DiplomInformatikerFranzHoepfinger/mpcie-breakout/photos/mpcie-breakout-back.jpg

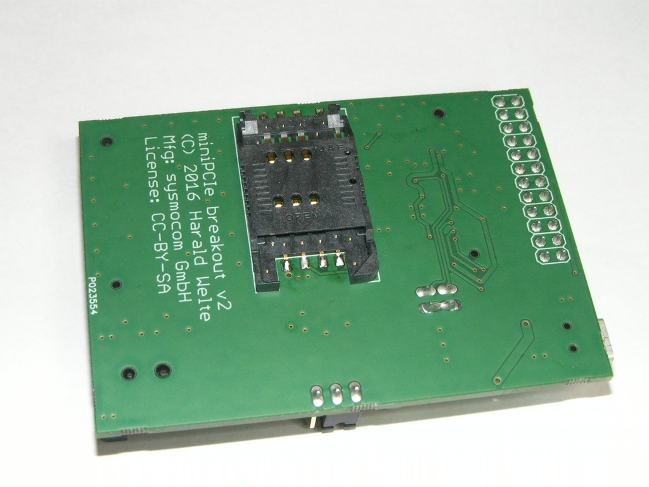
photos/mpcie-breakout-back.jpg
