DiplomInformatikerFranzHoepfinger/mpcie-breakout/photos/mpcie-breakout-v3-perspective.jpg

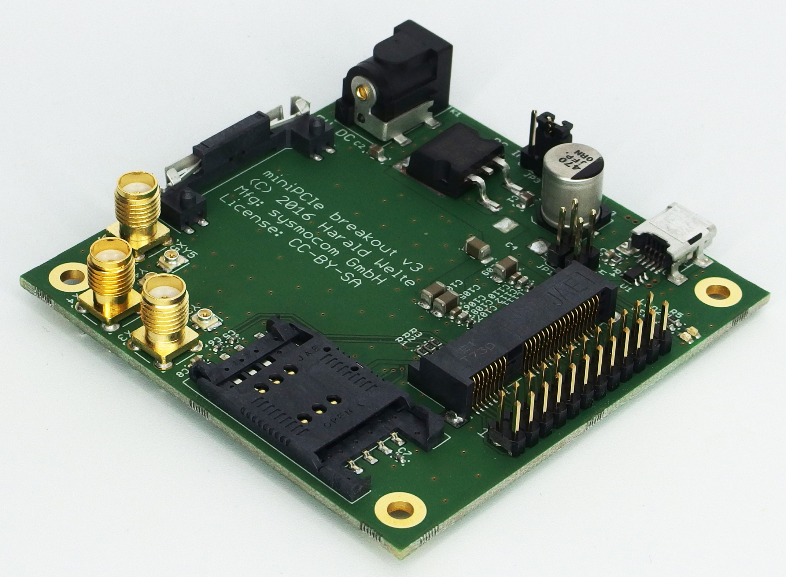
photos/mpcie-breakout-v3-perspective.jpg
