DiplomInformatikerFranzHoepfinger/mpcie-breakout/README.md

# mpcie-breakout
https://osmocom.org/projects/mpcie-breakout/wiki --> advance this.
