DiplomInformatikerFranzHoepfinger/mpcie-breakout/photos/mpcie-breakout-front.jpg

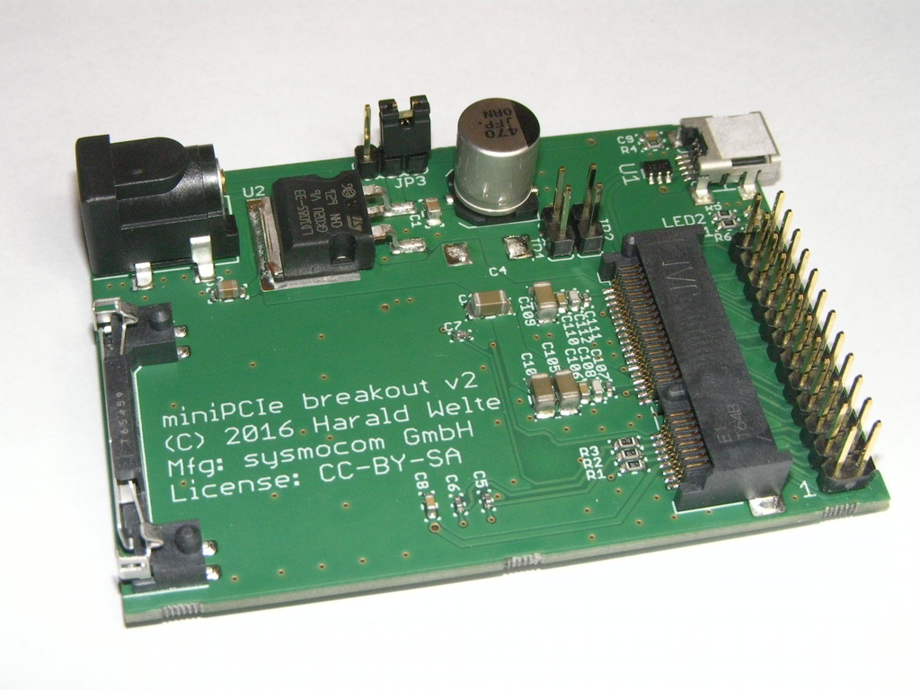
photos/mpcie-breakout-front.jpg
