DiplomInformatikerFranzHoepfinger/mpcie-breakout/photos/mpcie-breakout-v3-top.jpg

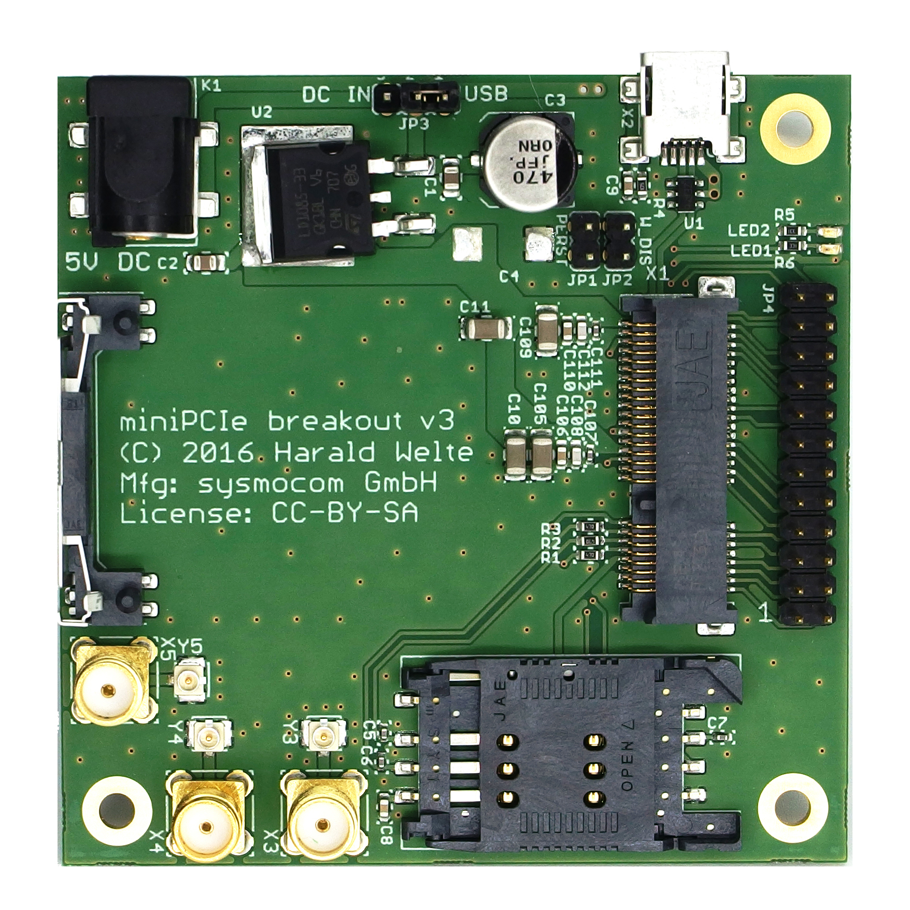
photos/mpcie-breakout-v3-top.jpg
