DiplomInformatikerFranzHoepfinger/mpcie-breakout/mpcie-breakout.pdf

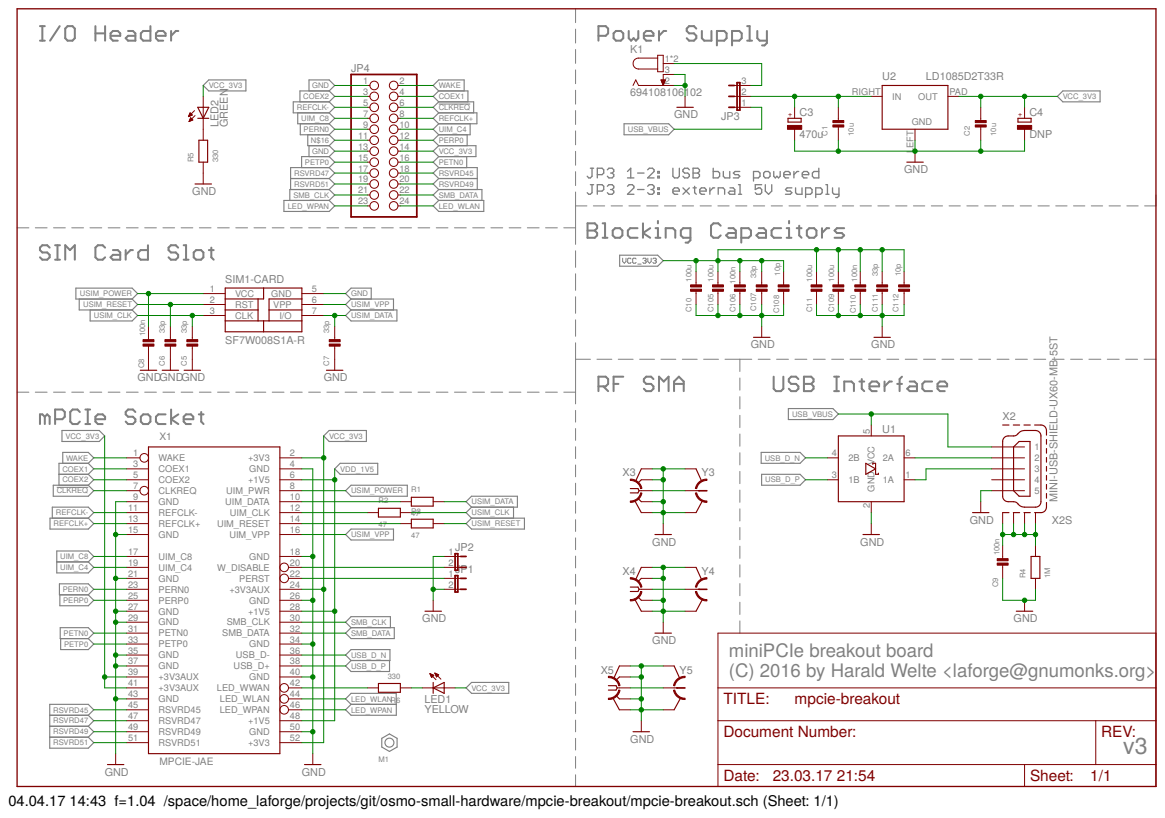
[picture p5: page 1]

MINI-USB-SHIELD-UX60-MB-5S

10 UIM_PWR 12 UIM_DATA
14 UIM_CLK
16 UIM_RESET

18 20 GND

30 +3V3AUX 26 28 GND

GND
miniPCIe breakout board
(C) 2016 by Harald Welte <laforge@gnumonks.org>
TITLE:
Document Number:

04.04.17 14:43 f=1.04 /space/home_laforge/projects/git/osmo-small-hardware/mpcie-breakout/mpcie-breakout.sch (Sheet: 1/1)
