DiplomInformatikerFranzHoepfinger/mpcie-breakout/mpcie-breakout_brd.pdf

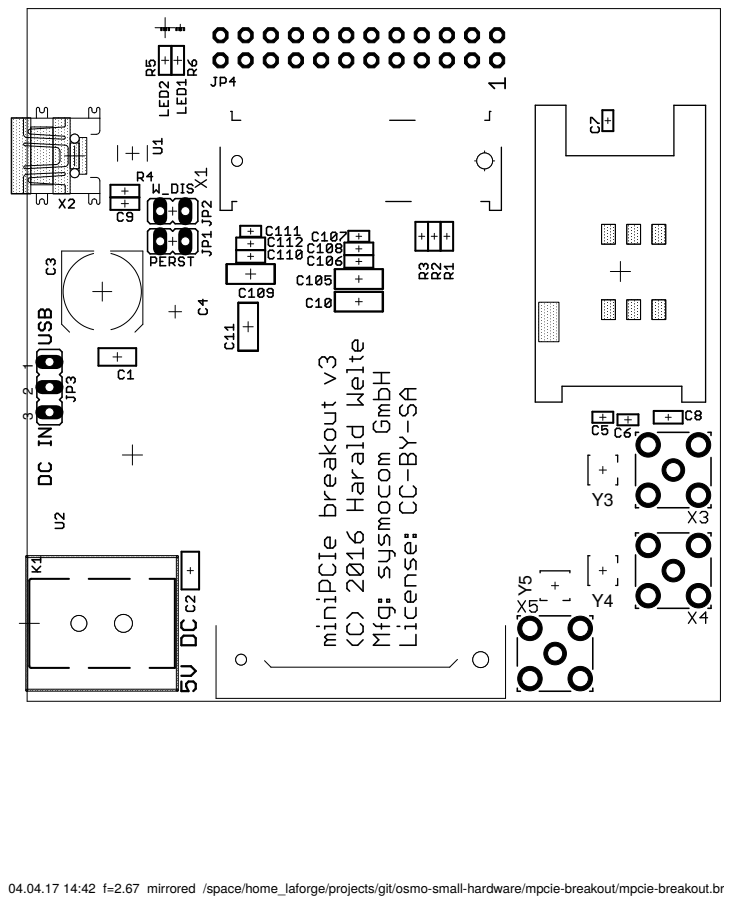
[picture p6: page 1]

04.04.17 14:42 f=2.67 mirrored /space/home_laforge/projects/git/osmo-small-hardware/mpcie-breakout/mpcie-breakout.brd
