DiplomInformatikerFranzHoepfinger/mpcie-breakout/mpcie-breakout.brd

## EAGLE design mpcie-breakout.brd (2021-05-27)

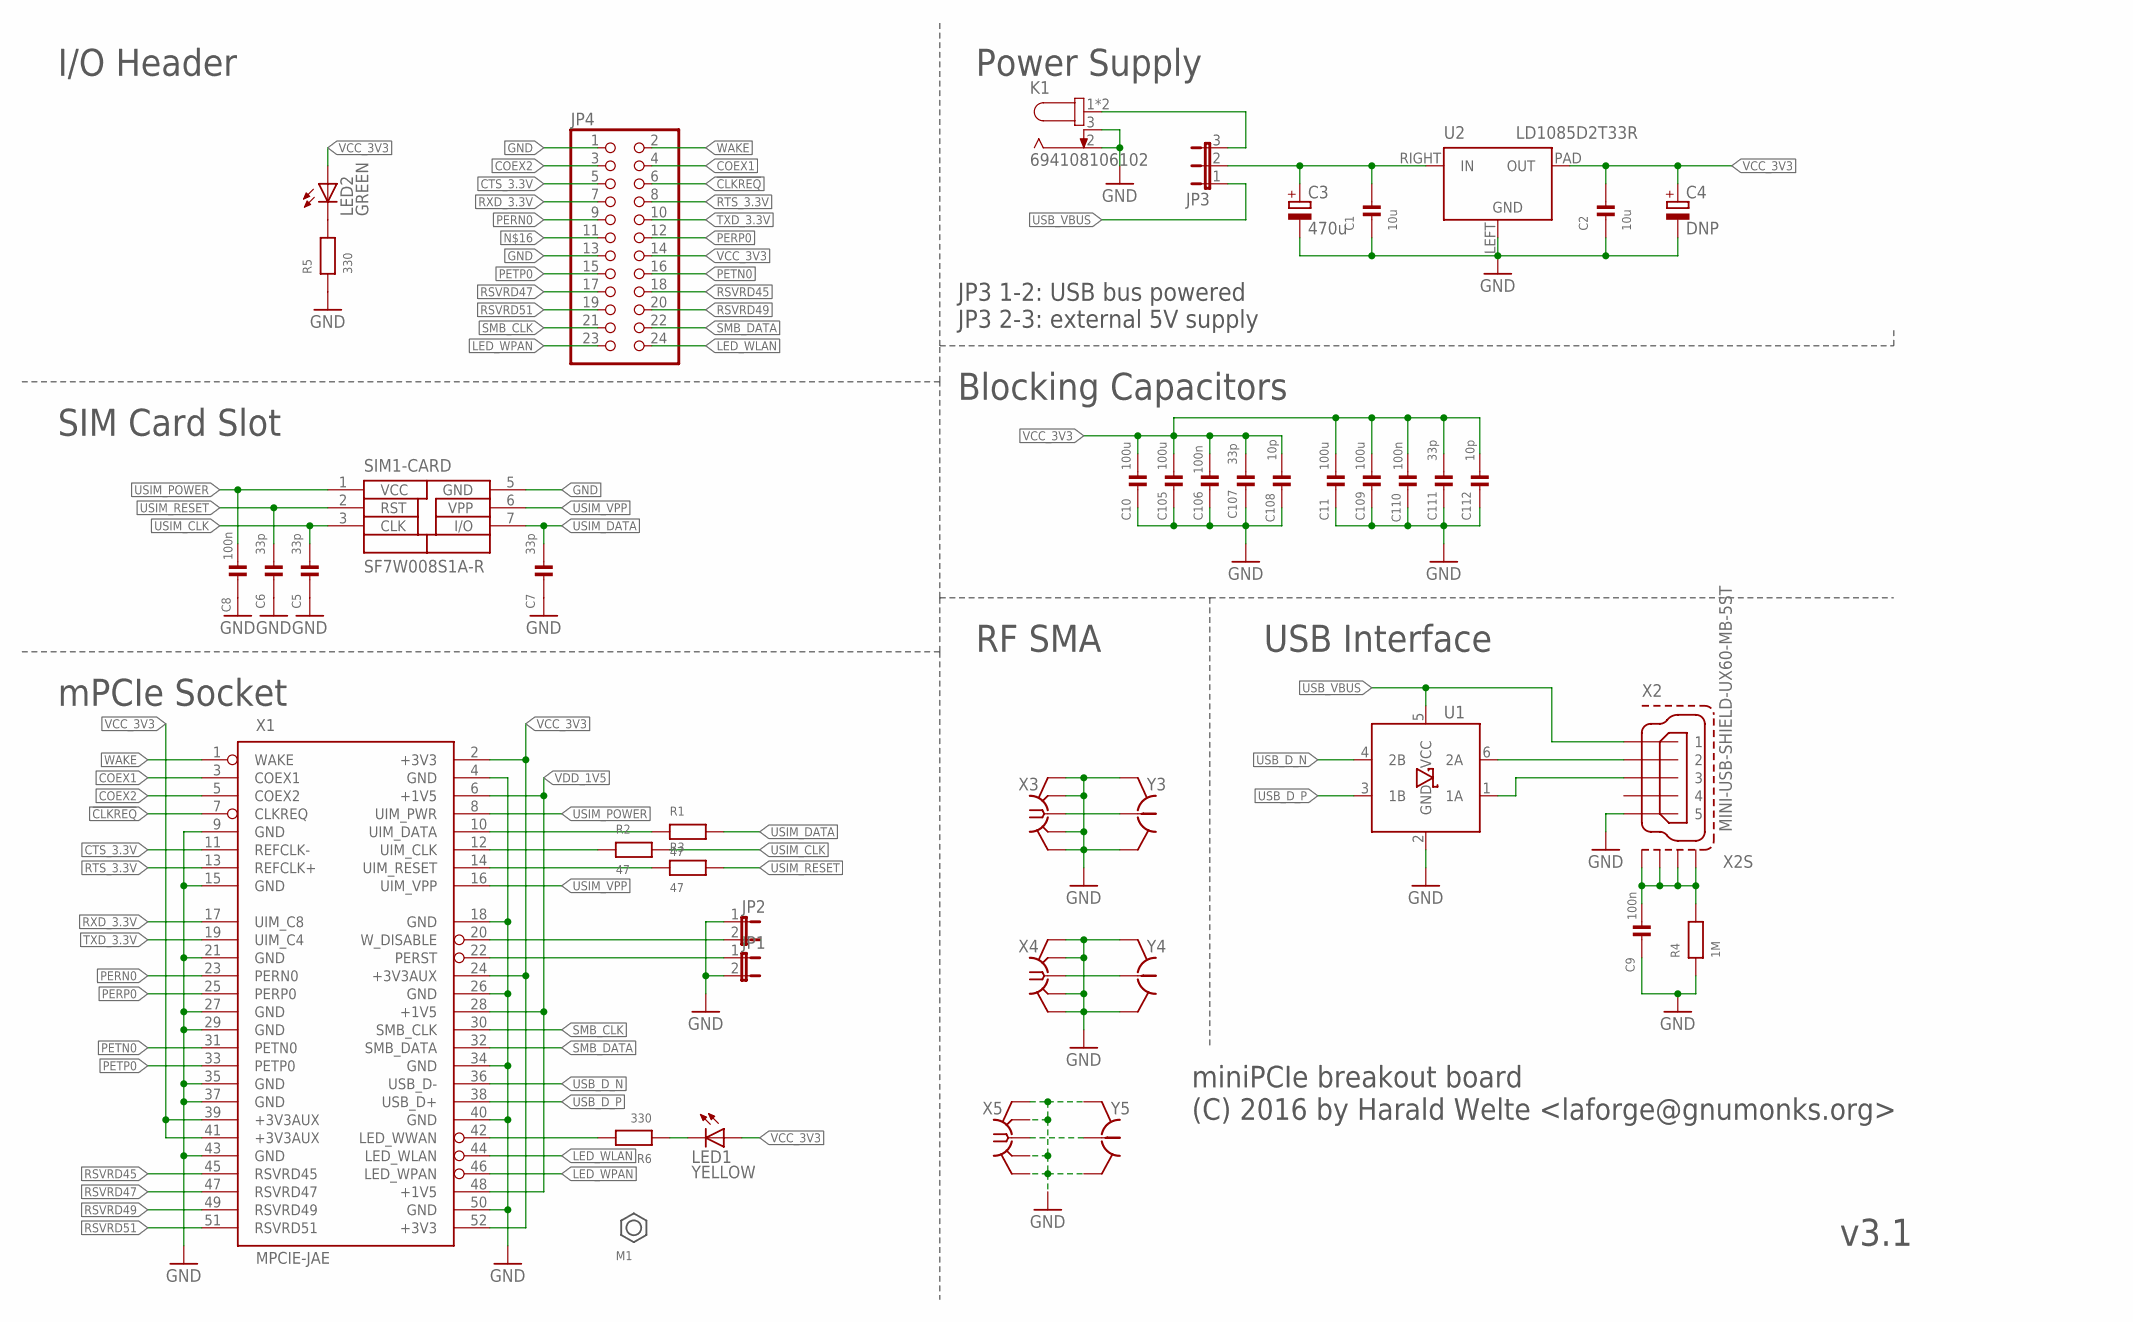
[picture p7: schematic mpcie-breakout.sch]

Parts:
C1, C2: 10u; _0805; MANUFACTURERPARTNUMBER CL21A106KOQNNNG
C3: 470u; UD-8X10_NICHICON; MANUFACTURERPARTNUMBER UUR0J471MNL1GS
C4: DNP; SMC_E; MANUFACTURERPARTNUMBER UNKNOWN MANUFACTURER PART NUMBER
C5, C6, C7, C107, C111: 33p; _0402; MANUFACTURERPARTNUMBER CL05C330JB5NNNC
C8, C9, C106, C110: 100n; _0603; MANUFACTURERPARTNUMBER CL10B104KO8NNNC
C10, C11, C105, C109: 100u; 1206; MANUFACTURERPARTNUMBER GRM31CR60J107ME39K
C108, C112: 10p; _0603; MANUFACTURERPARTNUMBER C0603C100J5GACTU
JP1, JP2: JP1E; JP1; MANUFACTURERPARTNUMBER UNKNOWN MANUFACTURER PART NUMBER
JP3: JP2E; JP2; MANUFACTURERPARTNUMBER UNKNOWN MANUFACTURER PART NUMBER
JP4: PINHD-2X12; 2X12; MANUFACTURERPARTNUMBER 961224-6404-AR
K1: 694108106102; MANUFACTURERPARTNUMBER 694108106102
LED1: YELLOW; CHIP-LED0603; MANUFACTURERPARTNUMBER UNKNOWN MANUFACTURER PART NUMBER
LED2: GREEN; CHIP-LED0603; MANUFACTURERPARTNUMBER UNKNOWN MANUFACTURER PART NUMBER
R1, R2, R3: 47; _0603; MANUFACTURERPARTNUMBER RC0603JR-0747RL
R4: 1M; _0603; MANUFACTURERPARTNUMBER RC0603JR-071ML
R5, R6: 330; _0603; MANUFACTURERPARTNUMBER RC0603JR-07330RL
SIM1: SF7W008S1A-R; SF7W008S1A-RESTR; MANUFACTURERPARTNUMBER SF7W008S1AE900
U1: IP4234CZ6; TSOP-6; MANUFACTURERPARTNUMBER IP4234CZ6,125
U2: LD1085D2T33R; ST_D2PAK; MANUFACTURERPARTNUMBER LD1085D2T33R
X1: MPCIE-JAE; MM60-52; MANUFACTURERPARTNUMBER MM60-52B1-E1-R650
X2: MINI-USB-SHIELD-UX60-MB-5ST; UX60-MB-5ST; MANUFACTURERPARTNUMBER UX60-MB-5ST
X3, X4, X5: SMA-F-S-TH; MANUFACTURERPARTNUMBER 5-1814832-1
Y3, Y4, Y5: HRS_UFL; MANUFACTURERPARTNUMBER U.FL-R-SMT(01)

Connections:
!CLKREQ: JP4.6, X1.7 (CLKREQ)
COEX1: JP4.4, X1.3 (COEX1)
COEX2: JP4.3, X1.5 (COEX2)
CTS_3.3V: JP4.5, X1.11 (REFCLK-)
GND: C1.1, C2.1, C3.-, C4.-, C5.2, C6.2, C7.2, C8.1, C9.1, C10.1, C11.1, C105.1, C106.1, C107.2, C108.2, C109.1, C110.1, C111.2, C112.2, JP1.2, JP2.1, JP4.1, JP4.13, K1.2, K1.3, R4.1, R5.1, SIM1.5 (GND), U1.2 (GND), U2.LEFT (GND), X1.4 (GND), X1.9 (GND), X1.15 (GND), X1.18 (GND), X1.21 (GND), X1.26 (GND), X1.27 (GND), X1.29 (GND), X1.34 (GND), X1.35 (GND), X1.37 (GND), X1.40 (GND), X1.43 (GND), X1.50 (GND), X2.5, X3.G1 (GND), X3.G2 (GND), X3.G3 (GND), X3.G4 (GND), X4.G1 (GND), X4.G2 (GND), X4.G3 (GND), X4.G4 (GND), X5.G1 (GND), X5.G2 (GND), X5.G3 (GND), X5.G4 (GND), Y3.GND@1 (GND), Y3.GND@2 (GND), Y4.GND@1 (GND), Y4.GND@2 (GND), Y5.GND@1 (GND), Y5.GND@2 (GND)
LDO_IN: C1.2, C3.+, JP3.2, U2.RIGHT (IN)
LED_WLAN: JP4.24, X1.44 (LED_WLAN)
LED_WPAN: JP4.23, X1.46 (LED_WPAN)
unnamed: LED2.C, R5.2
unnamed: LED1.C, R6.1
unnamed: R6.2, X1.42 (LED_WWAN)
unnamed: R1.1, X1.10 (UIM_DATA)
unnamed: X5.C (1), Y5.SIG (1)
unnamed: R2.1, X1.12 (UIM_CLK)
unnamed: R3.1, X1.14 (UIM_RESET)
unnamed: C9.2, R4.2, X2.M1 (S1), X2.M2 (S2), X2.M3 (S3), X2.M4 (S4)
unnamed: JP3.3, K1.1, K1.1-1 (1)
unnamed: X3.C (1), Y3.SIG (1)
unnamed: X4.C (1), Y4.SIG (1)
PERN0: JP4.9, X1.23 (PERN0)
PERP0: JP4.12, X1.25 (PERP0)
PERST: JP1.1, X1.22 (PERST)
PETN0: JP4.16, X1.31 (PETN0)
PETP0: JP4.15, X1.33 (PETP0)
RSVRD45: JP4.18, X1.45 (RSVRD45)
RSVRD47: JP4.17, X1.47 (RSVRD47)
RSVRD49: JP4.20, X1.49 (RSVRD49)
RSVRD51: JP4.19, X1.51 (RSVRD51)
RTS_3.3V: JP4.8, X1.13 (REFCLK+)
RXD_3.3V: JP4.7, X1.17 (UIM_C8)
SMB_CLK: JP4.21, X1.30 (SMB_CLK)
SMB_DATA: JP4.22, X1.32 (SMB_DATA)
TXD_3.3V: JP4.10, X1.19 (UIM_C4)
USB_D_N: U1.4 (2B), X1.36 (USB_D-)
USB_D_P: U1.3 (1B), X1.38 (USB_D+)
USB_VBUS: JP3.1, U1.5 (VCC), X2.1
USIM_CLK: C5.1, R2.2, SIM1.3 (CLK)
USIM_DATA: C7.1, R1.2, SIM1.7 (I/O)
USIM_POWER: C8.2, SIM1.1 (VCC), X1.8 (UIM_PWR)
USIM_RESET: C6.1, R3.2, SIM1.2 (RST)
USIM_VPP: SIM1.6 (VPP), X1.16 (UIM_VPP)
VCC_3V3: C2.2, C4.+, C10.2, C11.2, C105.2, C106.2, C107.1, C108.1, C109.2, C110.2, C111.1, C112.1, JP4.14, LED1.A, LED2.A, U2.PAD (OUT), X1.2 (+3V3), X1.24 (+3V3AUX), X1.39 (+3V3AUX), X1.41 (+3V3AUX), X1.52 (+3V3)
VDD_1V5: X1.6 (+1V5), X1.28 (+1V5), X1.48 (+1V5)
WAKE: JP4.2, X1.1 (WAKE)
W_DISABLE: JP2.2, X1.20 (W_DISABLE)
_USB_D_N: U1.6 (2A), X2.2
_USB_D_P: U1.1 (1A), X2.3

Notes on the sheet:
miniPCIe breakout board (C) 2016 by Harald Welte <laforge@gnumonks.org>
I/O Header
SIM Card Slot
mPCIe Socket
Power Supply
Blocking Capacitors
USB Interface
JP3 1-2: USB bus powered JP3 2-3: external 5V supply
RF SMA

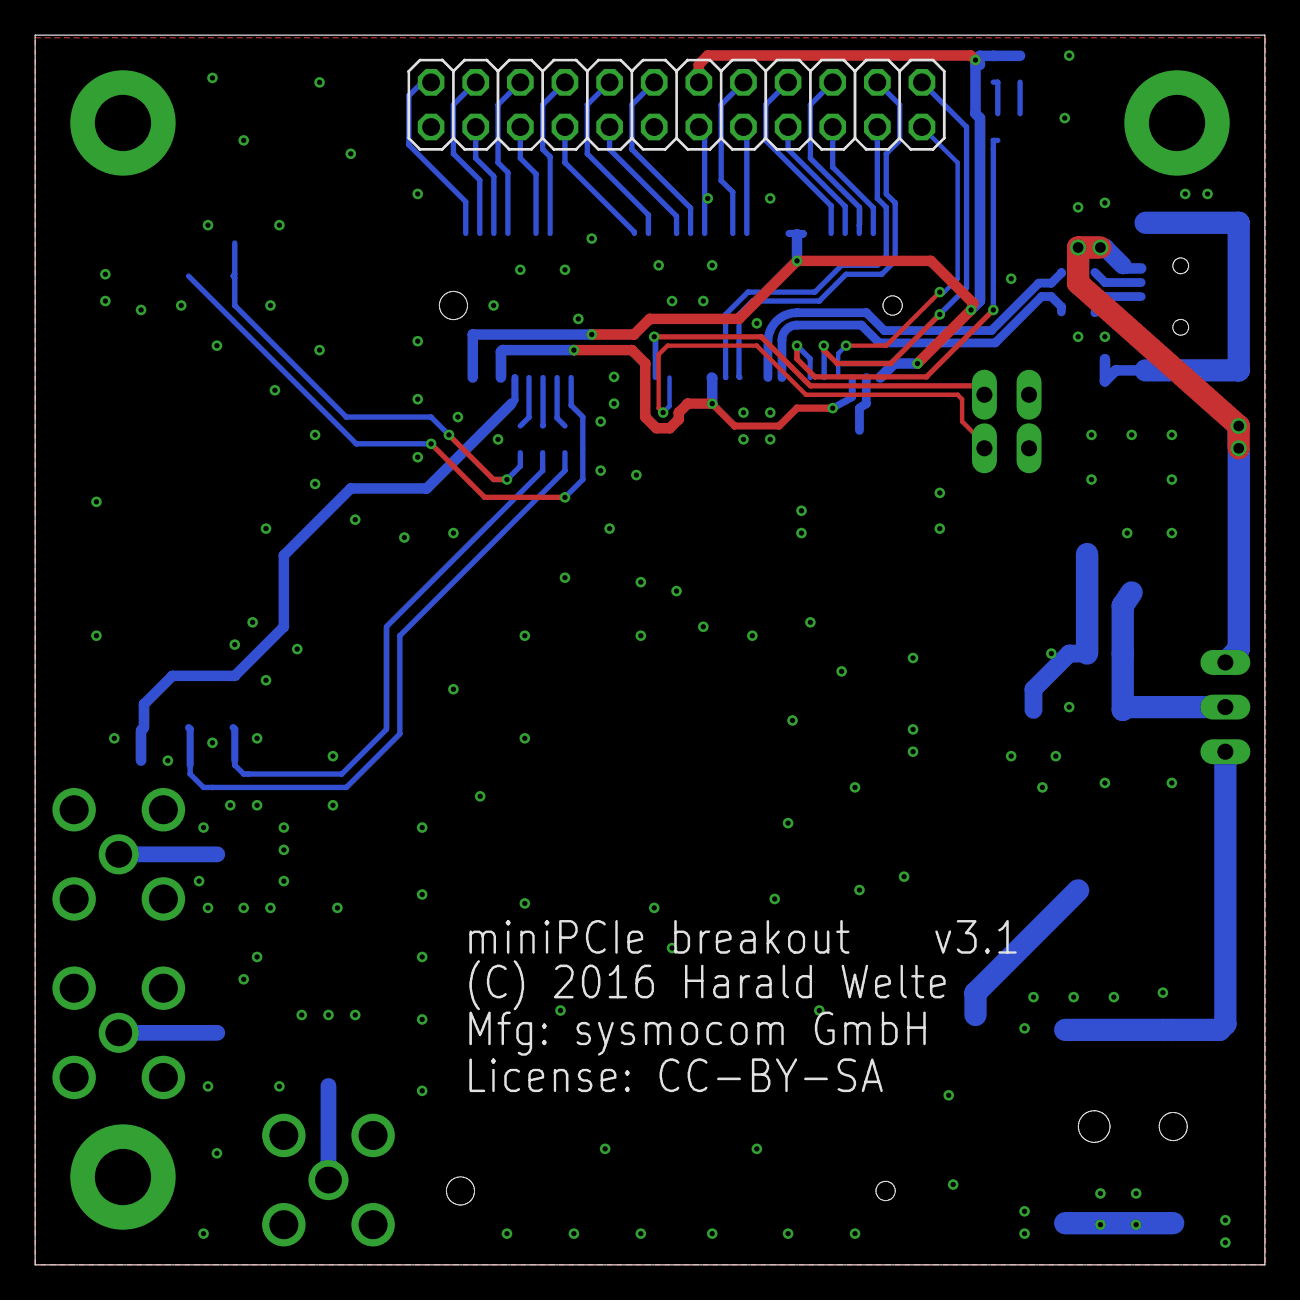
[picture p8: board mpcie-breakout.brd from above]

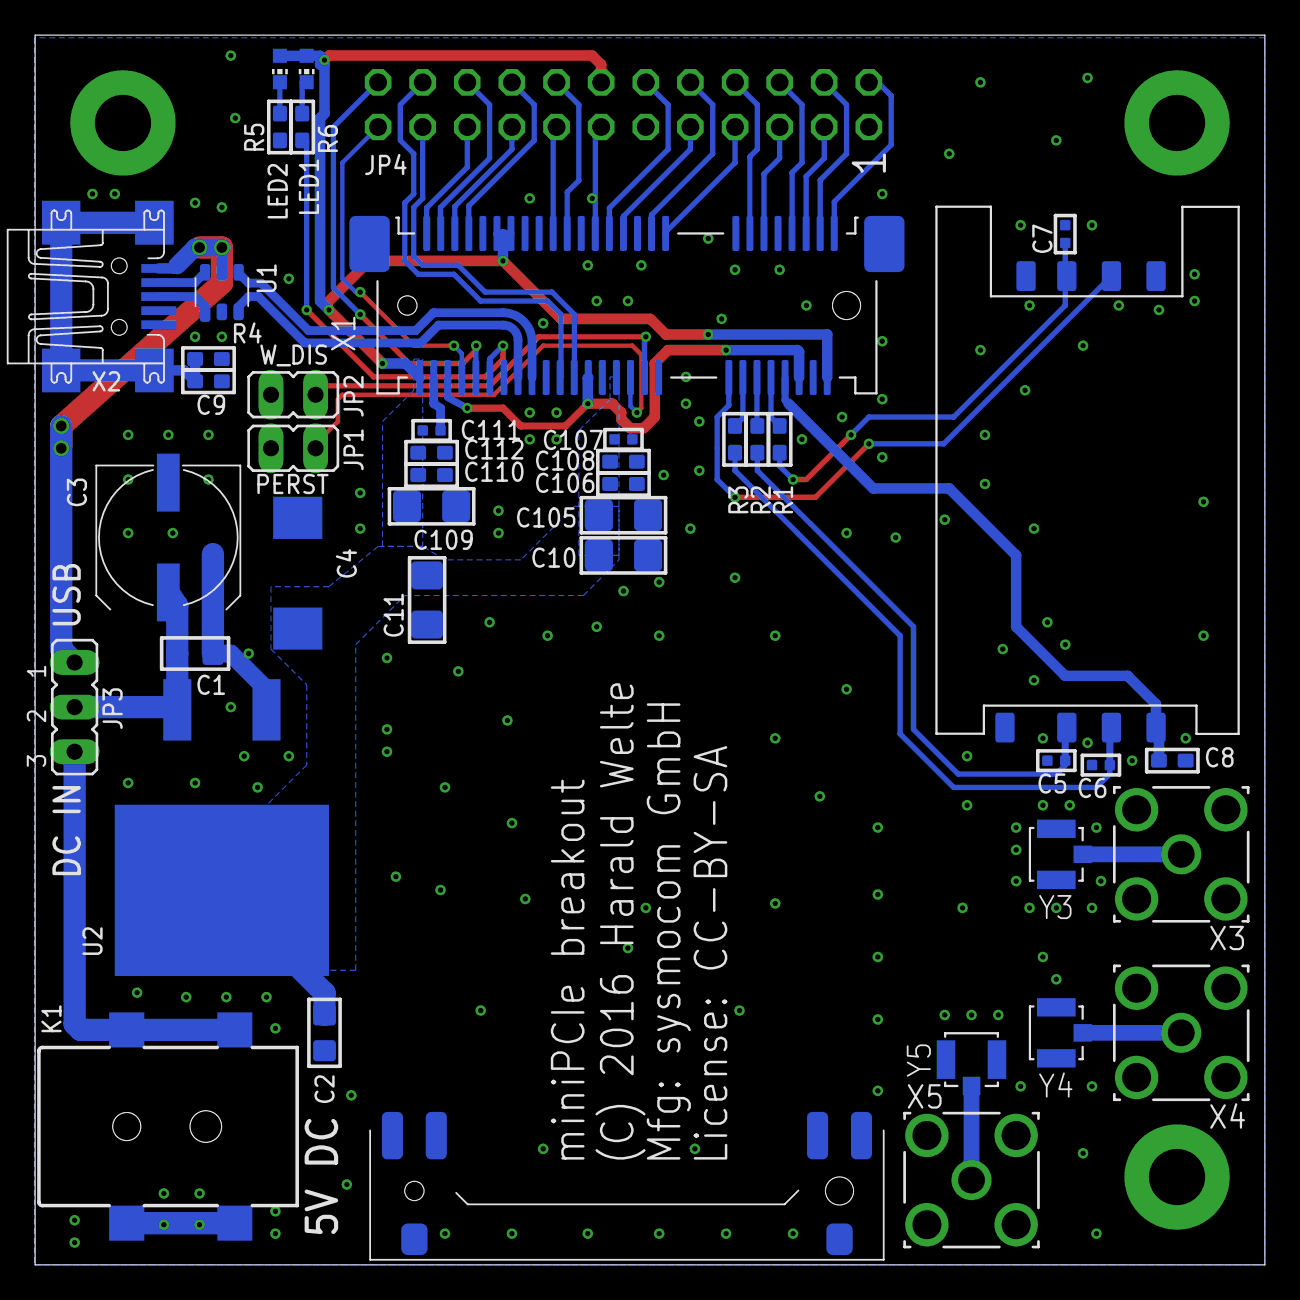
[picture p9: board mpcie-breakout.brd from below]

Board: 2 copper layers, 70.0 x 70.0 mm, 43 parts (42 on the bottom side), 47 nets.
