DiplomInformatikerFranzHoepfinger/mpcie-breakout/(commit log)

2021-05-27 osmo-small-hardware\mpcie-breakout
    Original here: https://osmocom.org/projects/mpcie-breakout/wiki
    [mpcie-breakout.GBL, mpcie-breakout.GBO, mpcie-breakout.GBP, mpcie-breakout.GBS, mpcie-breakout.GTL, mpcie-breakout.GTO, mpcie-breakout.GTP, mpcie-breakout.GTS]
2021-05-27 eagle Version updated.
    [mpcie-breakout.brd, mpcie-breakout.sch]
2021-05-27 added RXD, TXD, RTS, CTS
    [mpcie-breakout.brd, mpcie-breakout.sch]
