DiplomInformatikerFranzHoepfinger/mpcie-breakout/(notices)

Notices in the files:
mpcie-breakout.brd:
(C) 2016 Harald Welte
License: CC-BY-SA
parts and their libraries:
Wurth_Elektronik_Electromechanic_DC_Powe: Copyright: Würth Elektronik
